jkelly-westcall/OrienteeringHAT/README.md

# OrienteeringHAT
 Orienteering Electronic Timing System
Jack Kelly
