jkelly-westcall/OrienteeringHAT/Pictures/Orienteering Timing System Pictures.pdf

## Orienteering Timing System Pictures

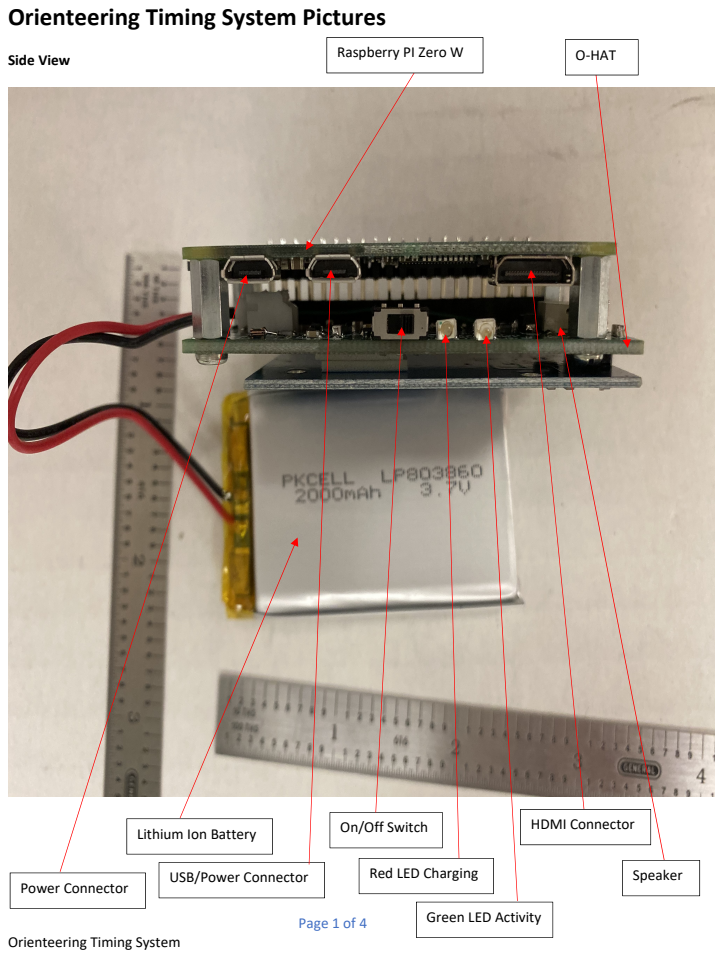
[picture p1: page 1]
Side View; Raspberry PI Zero W; O‐HAT; Power Connector; USB/Power Connector; Red LED Charging; On/Off Switch; HDMI Connector; Speaker

Lithium Ion Battery

Green LED Activity

Orienteering Timing System

Bottom View

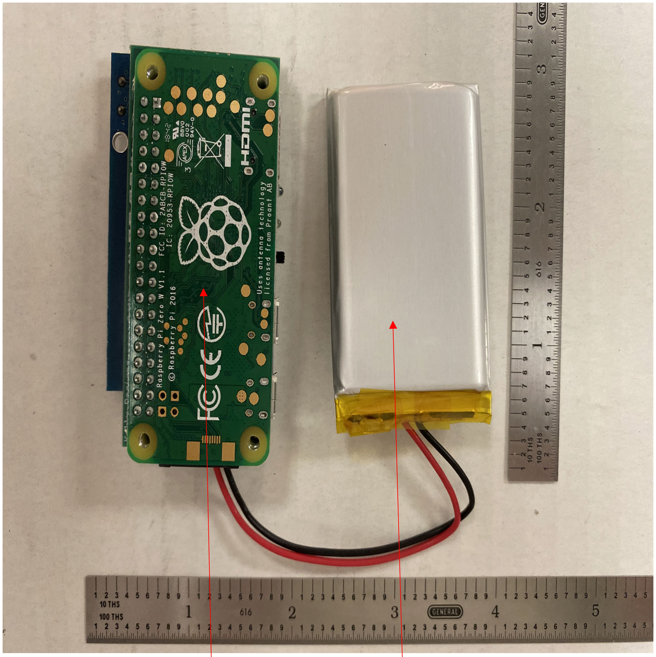
[picture p2: figure]

Raspberry Pi Zero W | Lithium Ion Battery

Top View

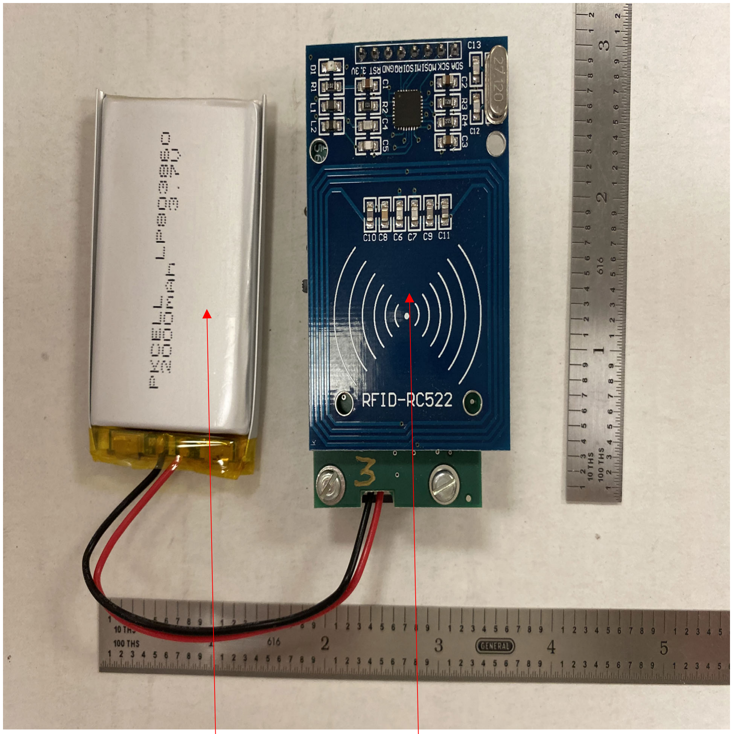
[picture p3: figure]

Smart Card Reader/Writer
Lithium Ion Battery

Control Card and UI Command Card

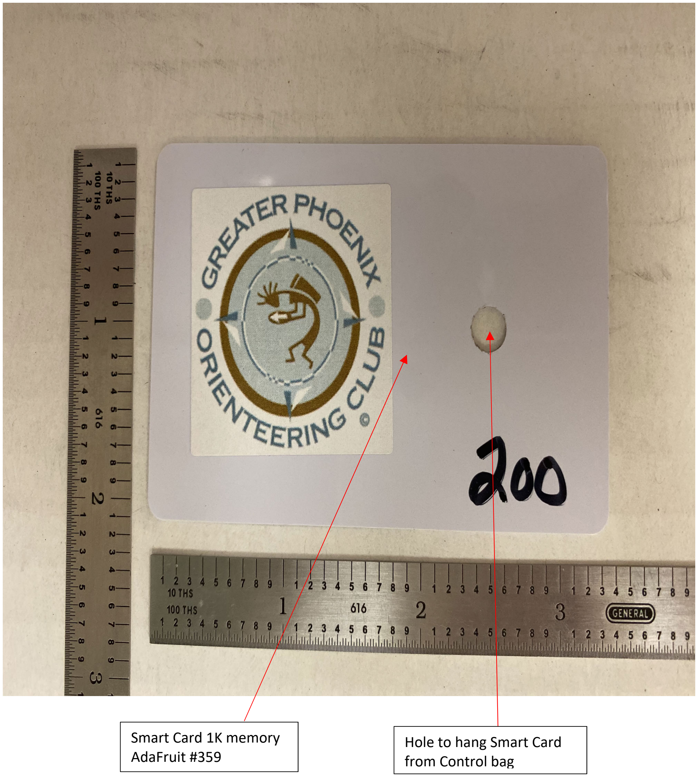
[picture p4: figure]
Smart Card 1K memory AdaFruit #359; Hole to hang Smart Card from Control bag
