jkelly-westcall/OrienteeringHAT/Rev P1/BOM/HAT Rev P1 BOM.xlsx

 |  |  |  | Orienteering HAT PN: 1287 Rev P1 |  | As of: 3/28/2019 Jack Kelly © Copyright 2019
Item | Qty | Location (bottom) | Mfg Part # | Description | Rating | Footprint | Mfg | Mouser | DigiKey | Notes | $ each | Total
1 | 6 | C1, C3, C4, C8, C9, C12 | CC0805KRX7R8BB104 | Cap Cer 0.1uF 25V X7R 10% 0805 | 10% | 0805 | Yageo | 603-CC805KRX7R8BB104 | 311-1141-1-ND |  | 0.052 | 0.312
2 | 4 | C2, C5, C10, C13 | CL21B106KPQNNNE | Cap Cer 10uF 10V X7R 10% 0805 | 10% | 0805 | Samsung | NA | 1276-1764-1-ND |  | 0.113 | 0.452
3 | 3 | C6, C7, C11 | CL21B475KPFNNNE | Cap Cer 4.7uF 10V X7R 10% 0805 | 10% | 0805 | Samsung | NA | CL21B475KPFNNNE |  | 0.094 | 0.282
4 | 1 | D1 | APDA3020LSECK/J3-PF | LED Red Clear RA |  |  | Kingbright | 604-APDA3020LSECKJ3F | 754-1925-1-ND |  | 0.328 | 0.328
5 | 1 | D2 | APDA3020LZGCK | LED Green Clear RA |  |  | Kingbright | 604-APDA3020LZGCK | 754-1929-1-ND |  | 0.350 | 0.350
6 | 1 | D3 | MRA4003T3G | Diode Gen Purp 300V 1A SMA |  | SMA | On Semi | 863-MRA4003T3G | MRA4003T3GOSCT-ND |  | 0.130 | 0.130
7 | 1 | F1 | 0ZCK0100FF2E | Fuse PTC Resttable 1.0A 6V Chip 0805 |  | 0805 | Bel Fuse | 530-0ZCK0100FF2E | 507-1815-1-ND |  | 0.185 | 0.185
8 | 1 | J1 | CS25582-40G-M36-0A | Conn Socket 2x20 0.100 inch SMD |  | 0.100 | Kaweei Tech | (Buy from Adafruit #2187) | NA |  | 1.950 | 1.950
9 | 1 | J2 | S2B-PH-K-S(LF)(SN) | Conn Header RA 2 Pos 2mm |  |  | JST | NA | S2B-PH-SM4-TB(LF)(SN) | 6 | 0.099 | 0.099
10 | 0 | J3 | NA | No Connector Installed |  |  | NA | NA | NA | 6 | 0.000 | 0.000
11 | 2 | Q1, Q2 | FDN340P | MOSFET P-Chan 20V 2A SSOT-3 |  | SSOT-3 | On Semi | 512-FDN340P | FDN340PCT-ND |  | 0.157 | 0.314
12 | 1 | Q3 | MMBT2222ALT1G | Trans NPN 40V 0.6A SOT-23 | 1% | SOT-23 | On Semi | 863-MMBT2222ALT1G | MMBT2222ALT1GOSCT-ND |  | 0.034 | 0.034
13 | 2 | R1, R10 | RC0805FR-07732KL | Res 732K Ohms 1% Thick Film 0805 | 1% | 0805 | Yageo | 603-RC0805FR-07732KL | 311-732KCRCT-ND |  | 0.017 | 0.034
14 | 1 | R2 | RC0805FR-07274KL | Res 274K Ohms 1% Thick Film 0805 | 1% | 0805 | Yageo | 603-RC0805FR-07274KL | 311-274KCRCT-ND |  | 0.017 | 0.017
15 | 3 | R3, R6, R13 | RC0805FR-07100KL | Res 100K Ohms 1% Thick Film 0805 | 1% | 0805 | Yageo | 603-RC0805FR-07100KL | 311-100KCRCT-ND |  | 0.017 | 0.051
16 | 1 | R4 | RC0805FR-072KL | Res 2K Ohms 1% Thick Film 0805 | 1% | 0805 | Yageo | 603-RC0805FR-072KL | 311-2.00KCRCT-ND |  | 0.017 | 0.017
17 | 1 | R5 | RC0805FR-074K99L | Res 4.99K Ohms 1% Thick Film 0805 | 1% | 0805 | Yageo | 603-RC0805FR-074K99L | 311-4.99KCRCT-ND |  | 0.017 | 0.017
18 | 1 | R7 | P442DACT-ND | Res 442 Ohms 0.1% Thin Film 0805 | 0.1% | 0805 | Panasonic | 667-ERA-6AEB4420V | P442DACT-ND |  | 0.125 | 0.125
19 | 2 | R8, R9 | RT0805BRD071KL | Res 1K Ohms 0.1% Thin Film 0805 | 0.1% | 0805 | Yageo | 603-RT0805BRD071KL | YAG1820CT-ND |  | 0.125 | 0.250
20 | 1 | R11 | RC0805FR-07432KL | Res 432K Ohms 1% Thick Film 0805 | 1% | 0805 | Yageo | 603-RC0805FR-07432KL | 311-432KCRCT-ND |  | 0.017 | 0.017
21 | 1 | R12 | RC0805FR-07909KL | Res 909K Ohms 1% Thick Film 0805 | 1% | 0805 | Yageo | 603-RC0805FR-07909KL | RC0805FR-07909KL |  | 0.017 | 0.017
22 | 1 | R14 | RC0805FR-07330RL | Res 330 Ohms 1% Thick Film 0805 | 1% | 0805 | Yageo | 603-RC0805FR-07330RL | RC0805FR-07330RL |  | 0.017 | 0.017
23 | 1 | R15 | RC0805FR-071KL | Res 1K Ohms 1% Thick Film 0805 | 1% | 0805 | Yageo | 603-RC0805FR-071KL | RC0805FR-071KL |  | 0.017 | 0.017
24 | 1 | SPK | SMT-0931-S-R | Audio Magnetic XDCR 3-5V SMD |  | SMD | PUI | 665-SMT0931SR | 668-1479-1-ND |  | 1.452 | 1.452
25 | 1 | SW1 | EG1270 | Switch Slide SPDT 300mA 6V RA |  |  | E-Switch | 612-EG1270 | EG1847-ND | 6 | 0.625 | 0.625
26 | 1 | U1 | MCP73831T-2ATI/OT | IC Controller Li-Ion 4.2V SOT23-5 |  | SOT23-5 | Microchip | 579-MCP73831T-2ATIOT | MCP73831T-2ATI/OTDKR-ND |  | 0.450 | 0.450
27 | 2 | U2, U5 | MIC842HYC5-TR | IC Compartor w/Ref Open Drain |  | SC-70-5 | Microchip | 998-MIC842HYC5TR | 576-2926-1-ND |  | 0.420 | 0.840
28 | 1 | U3 | ADS1014BQDGSRQ1 | IC ADC 12-Bit I2C SMD |  | 10-MSOP | TI | 595-ADS1014BQDGSRQ1 | 296-45252-1-ND |  | 2.245 | 2.245
29 | 3 | U8, U4, U9 | SN74LVC1G06DBVR | IC Inverter SGL 1 input SOT23-5 |  | SOT23-5 | TI | 595-SN74LVC1G06DBVR | 296-8483-1-ND |  | 0.134 | 0.402
30 | 1 | U6 | MAX40200AUK+T | IC Ideal Diode SOT23-5 |  | SOT23-5 | Maxim | 700-MAX40200AUK+T | MAX40200AUK+TCT-ND |  | 0.629 | 0.629
31 | 1 | U7 | 74LVC1G07DBVT | IC Buffer Non-Invert 1 input SOT23-5 |  | SOT23-5 | TI | 595-SN74LVC1G07DBVT | 296-26590-1-ND |  | 0.400 | 0.400
32 | 0 | U10 | CM200C32768HZFT | Crystal 32.7680KHZ 12.5pF SMD |  |  | Citizen | 695-CM200C32.7KEZFUT (10ppm) | CM200C32768HZFT (5ppm) |  | 0.827 | 0.000
33 | 0 | U11 | PCF85263AT/AJ | IC RTC Clk/Calendar I2C 8SOIC |  | SOIC 8 | NXP | 771-PCF85263AT/AJ | PCF85263AT |  | 0.693 | 0.000
34 | 1 | V1 | VC120605D150DP | TVS 5.6VDC 150A 1206 |  | 1206 | AVX | 581-VC120605D150DP | 478-2517-1-ND |  | 0.385 | 0.385
35 | 1 |  |  | PCB Bare |  |  |  |  |  |  |  | 0.000
 |  |  |  |  |  | Sub total: |  |  | $12.44
 |  | Notes:
 | 1 | These components should be stocked due to concerns over lead time and/or limited substitutions available.
 | 2 | Cut pins flush to this board (0.030 inch or less)
 | 3 | Do not wash
 | 4
 | 5 | Leave holes open (do not fill with solder)
 | 6 | Thru-hole component
 | 7
