jkelly-westcall/OrienteeringHAT/Rev P1/BOM/HAT Coupling Kit Rev P1 BOM.xlsx

 |  |  |  | Orienteering HAT Coupling Kit PN: 1278 Rev P1 |  | As of: 3/3/2019 Jack Kelly © Copyright 2019
Item | Qty | Location (bottom) | Mfg Part # | Description | Rating | Footprint | Mfg | Mouser | DigiKey | Notes | $ each | Total
 |  |  |  | Assemble Explorer HAT to Raspberry PI
1 | 4 | M1, M2, M3,M4 | 970090151 | Hex Spacer M2.5 threaded Al 9mm |  |  | Wurth | NA | 732-10537-ND |  | 0.422 | 1.688
1 | 0 | M1, M2, M3,M4 | M1256-2545-SS | Hex Spacer M2.5 threaded SS 9mm |  |  | RAF Electronic | 761-M1256-2545-SS | 1772-1450-ND |  | 0.918 | 0.000
1 | 0 | M1, M2, M3,M4 | M1256-2545-AL | Hex Spacer M2.5 threaded Al 9mm |  |  | RAF Electronic | 761-M1256-2545-AL | 1772-1890-ND |  | 0.400 | 0.000
1 | 0 | M1, M2, M3,M4 | FM1256-2545-SS | Hex Spacer M2.5 threaded SS 9mm |  |  | Fascomp | 728-FM1256-2545-SS | NA |  | 0.616 | 0.000
2 | 8 | M1, M2, M3,M4 | 29300 | Screw Machine Pan M2.5 x 4mm |  |  | Keystone | 534-29300 | 36-29300-ND |  | 0.237 | 1.896
 |  |  |  |  |  | Sub total: |  |  | $3.58
 |  | Notes:
 | 1 | These components should be stocked due to concerns over lead time and/or limited substitutions available.
 | 2 | Cut pins flush to this board (0.030 inch or less)
 | 3 | Do not wash
 | 4
 | 5 | Leave holes open (do not fill with solder)
 | 6 | Thru-hole component
 | 7
