jkelly-westcall/OrienteeringHAT/Rev P1/BOM/HAT Pi Zero Kit Rev P1 BOM.xlsx

 |  |  |  | Orienteering HAT Pi Zero Kit PN: 1289 Rev P1 |  | As of: 3/3/2019 Jack Kelly © Copyright 2019
Item | Qty | Location (bottom) | Mfg Part # | Description | Rating | Footprint | Mfg | Mouser | DigiKey | Notes | $ each | Total
 |  |  |  | Parts for the Raspberry Pi Zero W
1 | 1 | Pi Zero W | 3400 | Raspberry Pi Zero W |  |  |  | Buy from Adafruit #3400 |  |  | 10.000 | 10.000
1 | 0 | Pi Zero W | 3708 | Raspberry Pi Zero WH |  |  |  | Buy from Adafruit #3708 |  |  | 14.000 | 0.000
2 | 1 | PI Zero Micro SD Card | SDSQUNC-016G-GN6MA SDSQUAR-016G-GN6MA | Micro SD Card 16GB Class 10 |  |  | SanDisk | Buy from Amazon | NA |  | 9.950 | 9.950
3 | 1 | PI Zero GPIO Conn | 2822 | Header male 2x20 0.100 inch |  | 0.100 |  | Buy from Adafruit #2822 | NA | 6 | 0.950 | 0.950
4 | 1 | HAT | LP-503562 | Lithium Ion Polymer Battery 3.7V 1200mAH |  |  |  | Buy from Adafruit #258 |  |  | 9.950 | 9.950
5 | 1 | HAT | RFID-RC522 | HiLetgo RFID kit Mifare RC522 RF ID |  |  | HiLetgo | Buy from Amazon |  |  | 5.490 | 5.490
6 | 1 | RFID-RC522 | 111-24 | Permanent Mounting Squares 1"x1" |  | 1"x1" | Scotch | Buy from Amazon |  |  | 0.200 | 0.200
 |  |  |  |  |  | Sub total: |  |  | $36.34
 |  | Notes:
 | 1 | These components should be stocked due to concerns over lead time and/or limited substitutions available.
 | 2 | Cut pins flush to this board (0.030 inch or less)
 | 3 | Do not wash
 | 4
 | 5 | Leave holes open (do not fill with solder)
 | 6 | Thru-hole component
 | 7
