jkelly-westcall/OrienteeringHAT/Rev P2/Schematic/Orienteering HAT Rev P2 Schematic.pdf

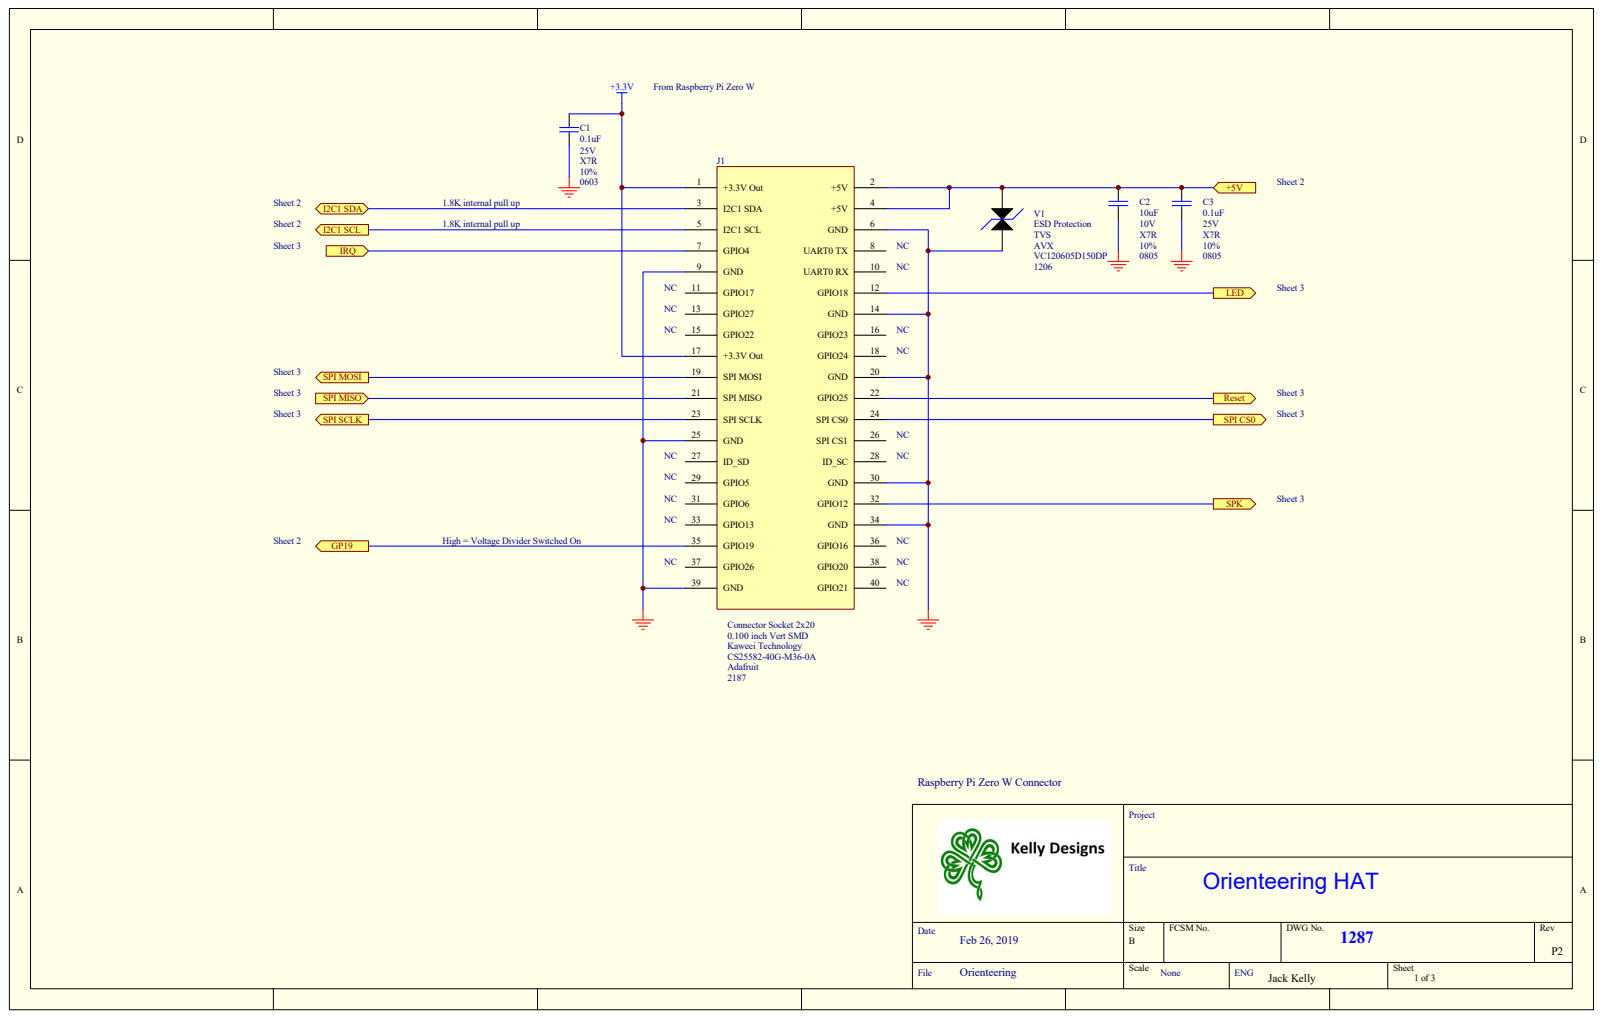
[picture p8: page 1]
Orienteering HAT; Project; Title; Connector Socket 2x20 0.100 inch Vert SMD Kaweei Technology CS25582-40G-M36-0A; From Raspberry Pi Zero W; I2C1 SDA; I2C1 SCL; Sheet 2; +3.3V Out 1; I2C1 SDA 3; I2C1 SCL 5; GND; GPIO4 7; UART0 TX; GND 9; UART0 RX; GPIO17 11; GPIO18; GPIO27 13; GPIO22 15; GPIO23; +3.3V Out 17; GPIO24; SPI MOSI 19; SPI MISO 21; GPIO25; SPI SCLK 23; SPI CS0; GND 25; SPI CS1; GPIO5 29; GPIO6 31; GPIO12; GPIO13 33; GPIO19 35; GPIO16; GPIO26 37; GPIO20; GND 39; GPIO21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

1.8K internal pull up

Raspberry Pi Zero W Connector

Date Feb 26, 2019 | Size B | FCSM No. | DWG No. 1287 | Rev P2

File Orienteering | Scale None | ENG Jack Kelly | Sheet 1 of 3

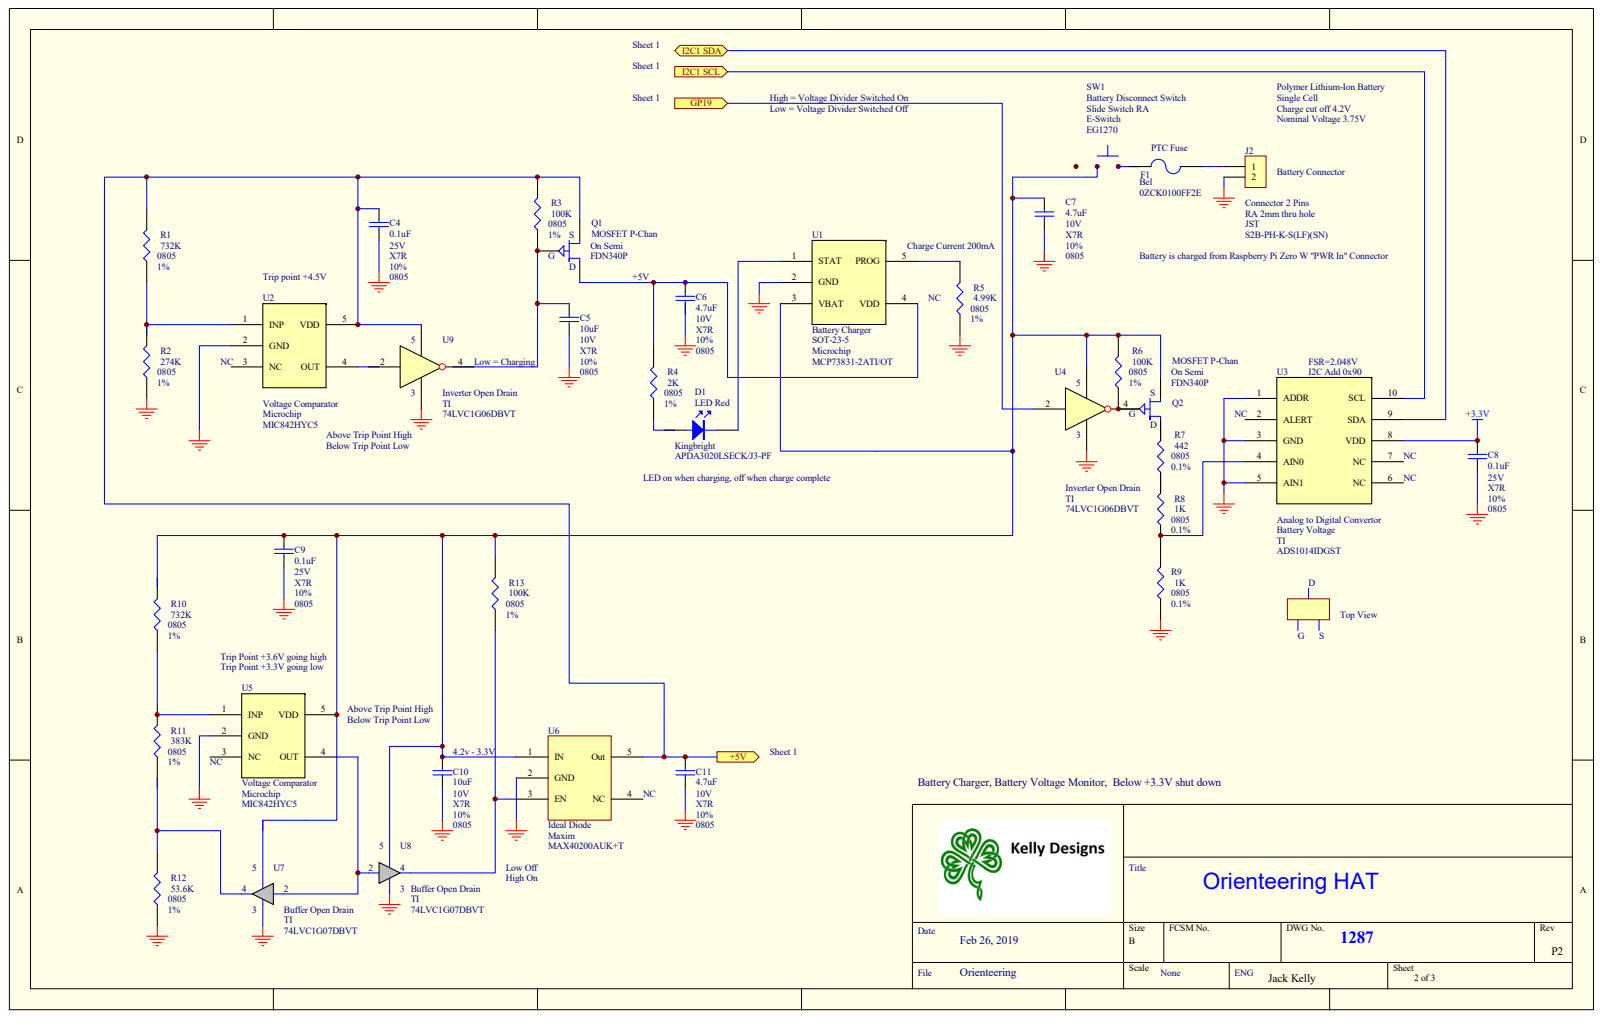
[picture p9: page 2]

Polymer Lithium-Ion Battery
Single Cell
Charge cut off 4.2V
Nominal Voltage 3.75V

High = Voltage Divider Switched On
Low = Voltage Divider Switched Off

Above Trip Point High
Below Trip Point Low

LED on when charging, off when charge complete

Trip Point +3.6V going high
Trip Point +3.3V going low

Battery Charger, Battery Voltage Monitor, Below +3.3V shut down

Date Feb 26, 2019 | Size B | FCSM No. | DWG No. 1287 | Rev P2

File Orienteering | Scale None | ENG Jack Kelly | Sheet 2 of 3

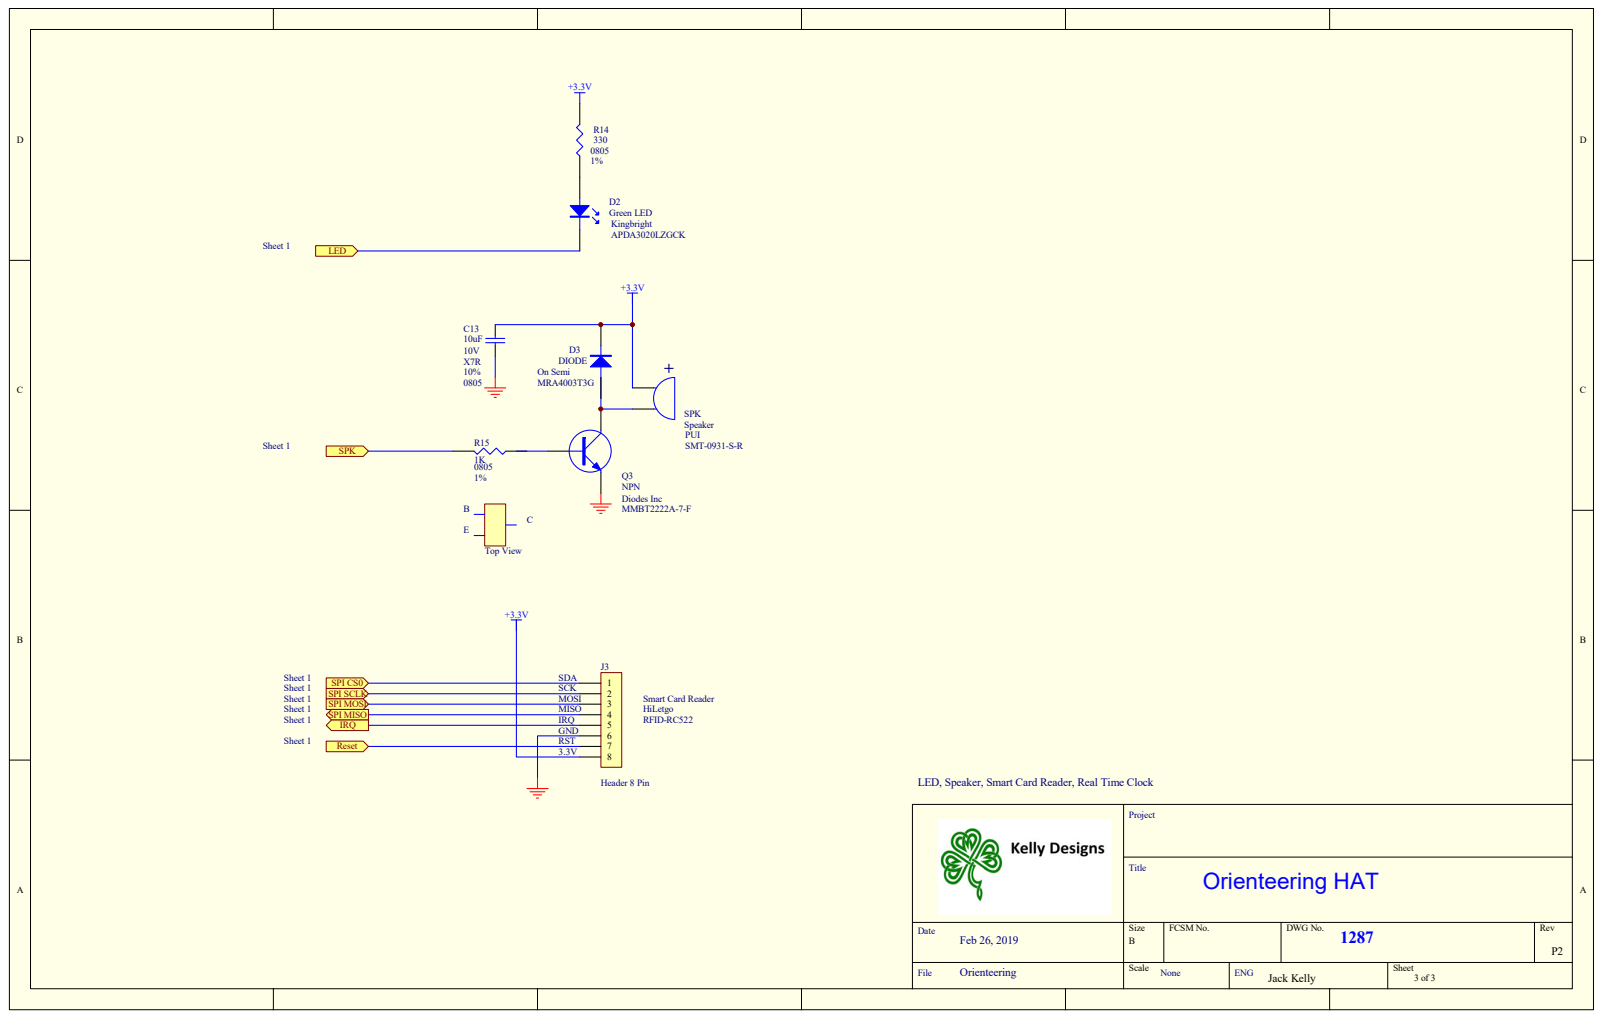
[picture p10: page 3]

LED, Speaker, Smart Card Reader, Real Time Clock

Date Feb 26, 2019 | Size B | FCSM No. | DWG No. 1287 | Rev P2

File Orienteering | Scale None | ENG Jack Kelly | Sheet 3 of 3
