jkelly-westcall/OrienteeringHAT/Rev P1/DeBug/Orienteering HAT DeBug Rev P1 to Rev P2.docx

To: Jack Kelly

From: Jack Kelly

Date: March 25, 2019

Subject: DeBug Log for Orienteering HAT Rev P1 to Rev P2

1. Speaker was J1 pin should be J1 pin32
2. Delete U10, U11 and C12
3. F1 footprint should be 0805
4. Silkscreen add Orienteering HAT to both sides

DeBug Log Page 1 of 1
