jkelly-westcall/OrienteeringHAT/(commit log)

2019-10-14 Rev P2
    [HAT Coupling Kit Rev P1 BOM.xlsx, HAT Pi Zero Kit Rev P1 BOM.xlsx, HAT Rev P2 BOM.xlsx]
2019-10-14 Update Oct 14, 2019
    [HAT Coupling Kit Rev P1 BOM.xlsx, HAT Pi Zero Kit Rev P1 BOM.xlsx, HAT Rev P1 BOM.xlsx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]
